YSajjad/Arduino-Temperature-Moniter/docs/Temperature Sensor V1.png

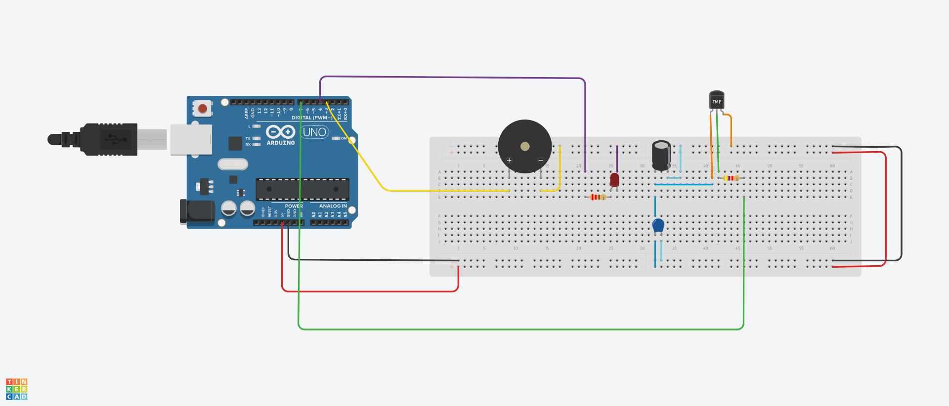
docs/Temperature Sensor V1.png
