YSajjad/Arduino-Temperature-Moniter/hardware/V1_local_alarm/V1TemperatureAlarm.jpg

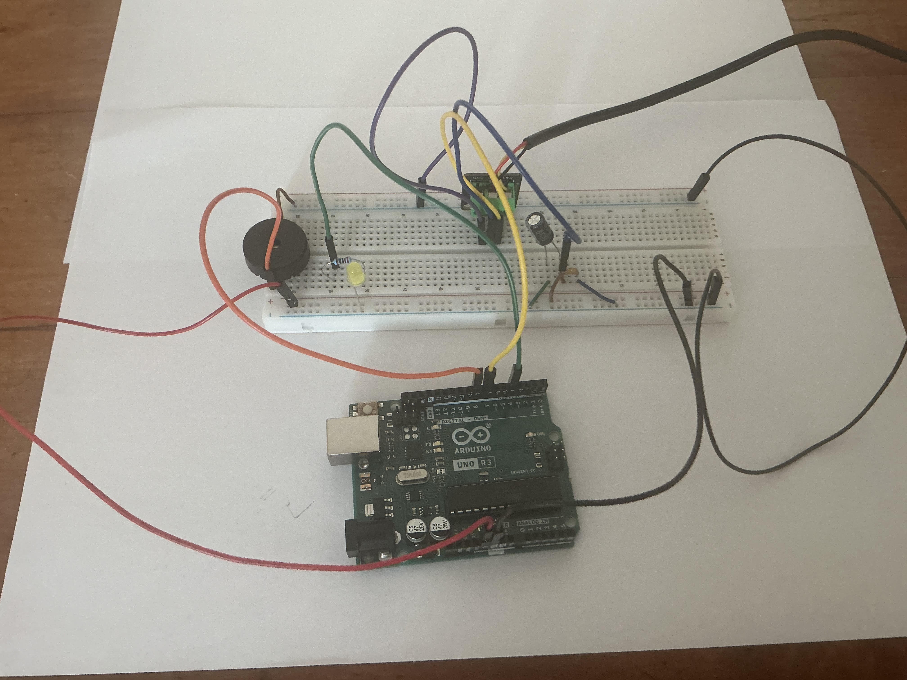
hardware/V1_local_alarm/V1TemperatureAlarm.jpg
