YSajjad/Arduino-Temperature-Moniter/hardware/V2_online_sensor/V2TemperatureSensor.jpeg

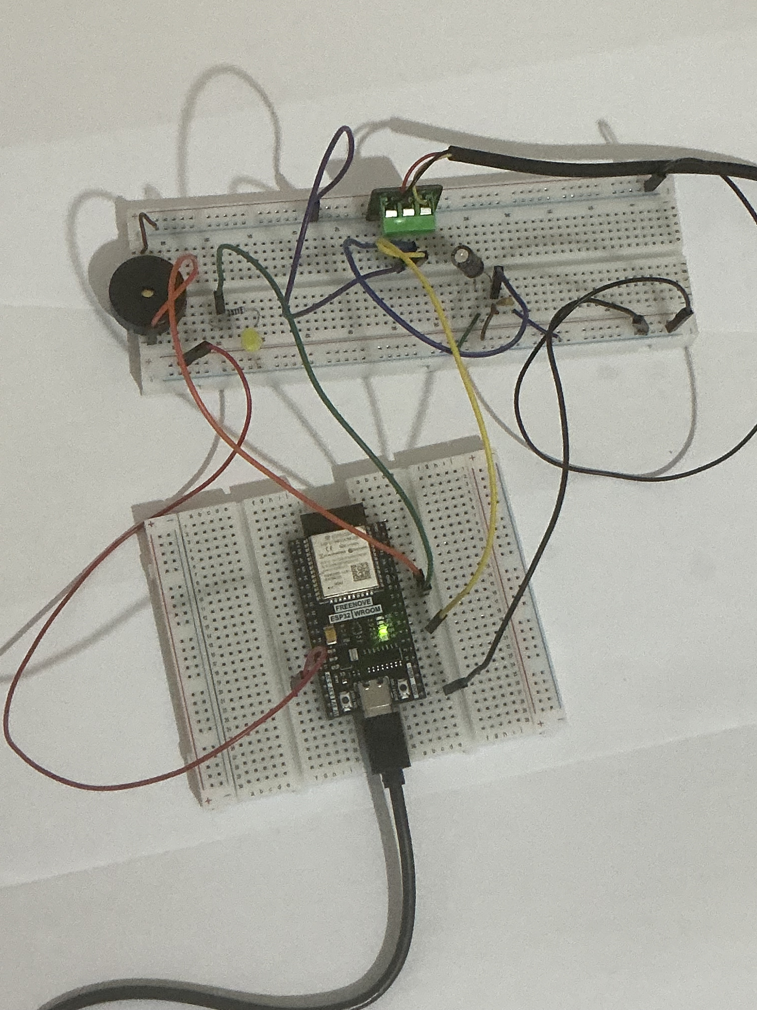
hardware/V2_online_sensor/V2TemperatureSensor.jpeg
