YSajjad/Arduino-Temperature-Moniter/hardware/V2_online_sensor/V2TemperatureSensorLCD.jpeg

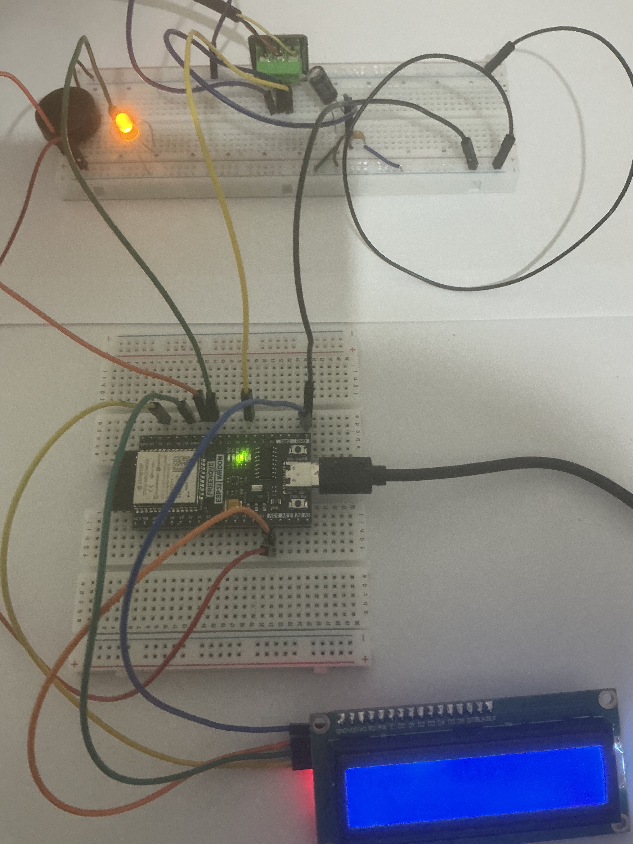
hardware/V2_online_sensor/V2TemperatureSensorLCD.jpeg
