YSajjad/Arduino-Temperature-Moniter/hardware/kikad/esp32TemperatureMonitor.pdf

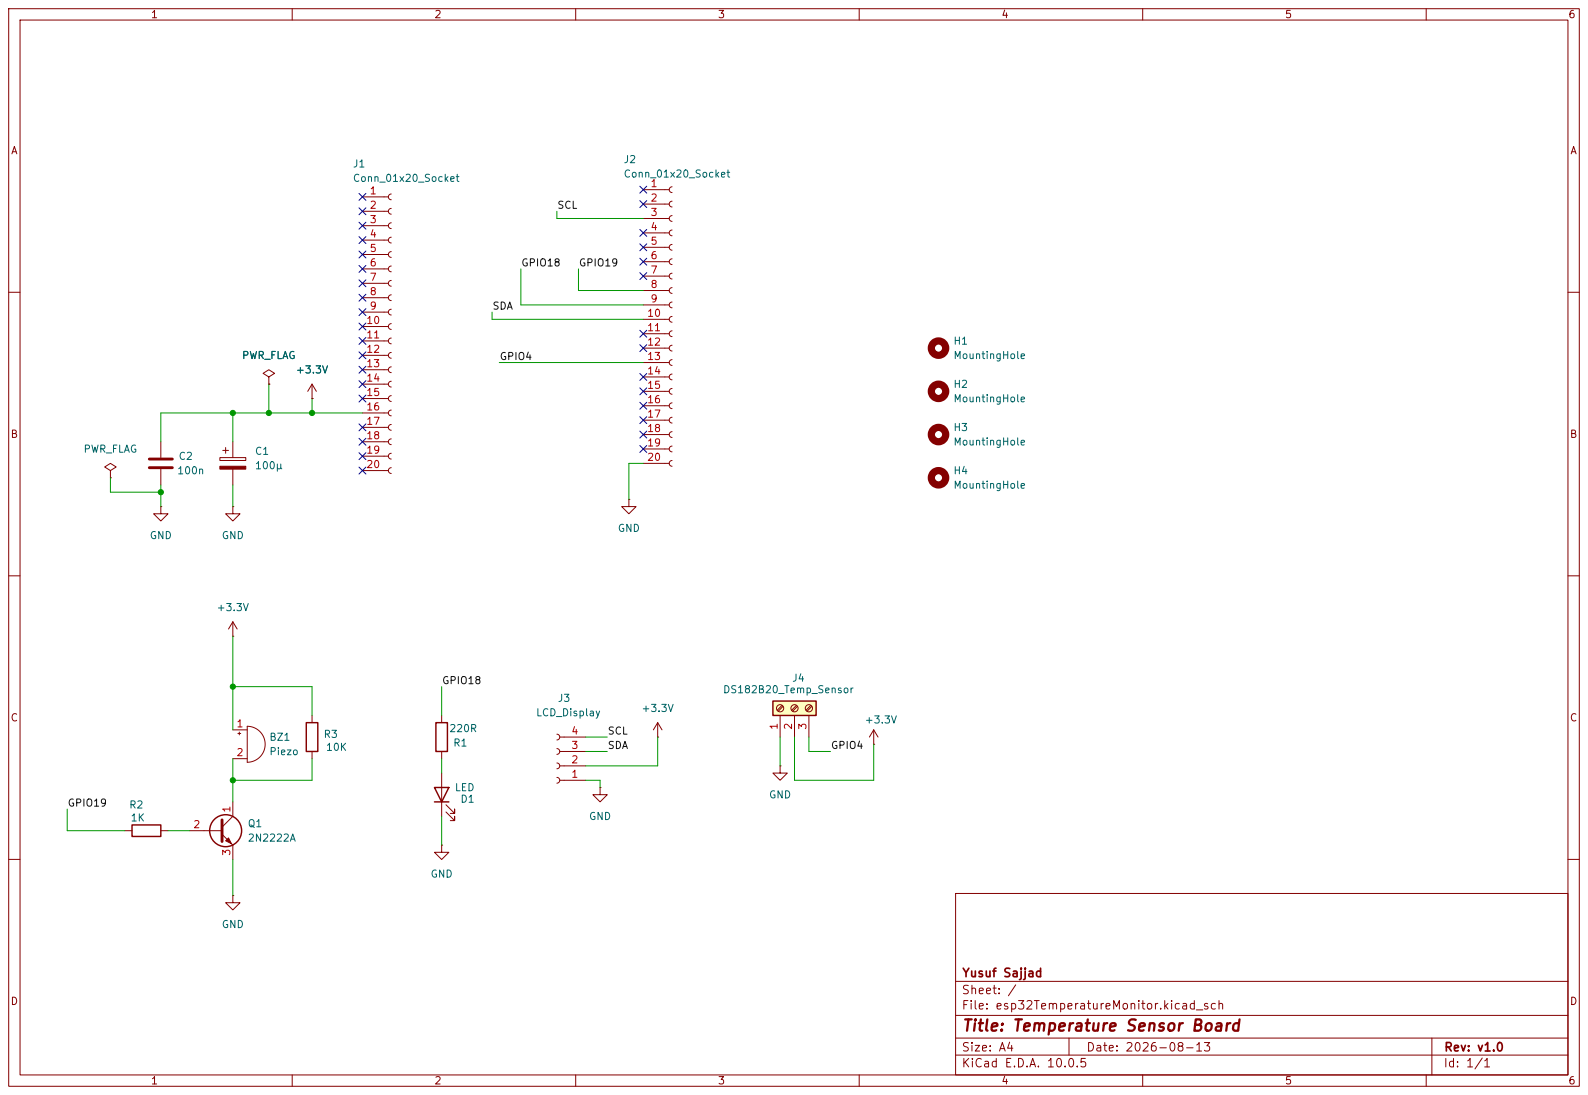
[picture p9: page 1]

Yusuf Sajjad
Sheet: /
File: esp32TemperatureMonitor.kicad_sch
Title: Temperature Sensor Board

Size: A4 | Rev: v1.0
KiCad E.D.A. 10.0.5 | Id: 1/1
