YSajjad/Arduino-Temperature-Moniter/(commit log)

2026-01-12 Rename Temperature Sensor V1.png to docs/Temperature Sensor V1.png
2026-07-12 Adding v1 code
    utilises DS18B20 readings to control a piezo and LED
2026-07-12 Version one bread board
2026-07-15 Create online_sensor.ino
    Code for v2
    uses the esp32 instead of the arduino UNO
    includes live logging over wifi (thingspeak)
    does not include LCD screen yet
2026-07-15 addition of version two sensor breadboarrd, no LCD
    LCD will be added in future
2026-08-13 Add files via upload
    Kikad schematic
2026-08-13 Add files via upload
    PCB layout
2026-08-27 Added final printed circuit bboard pictures
